junhyeong1211/visionpick-arm/media/figures/2026-11-11_fable-linkage-concept-not-physical.png

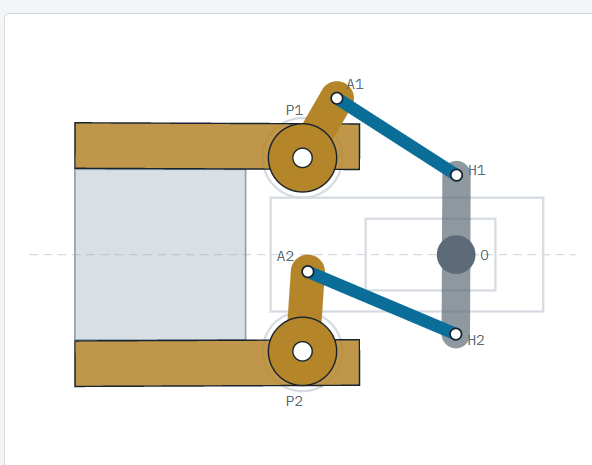
media/figures/2026-11-11_fable-linkage-concept-not-physical.png
