junhyeong1211/visionpick-arm/media/figures/2026-11-11_j5-gap-vs-servo-angle-2d.png

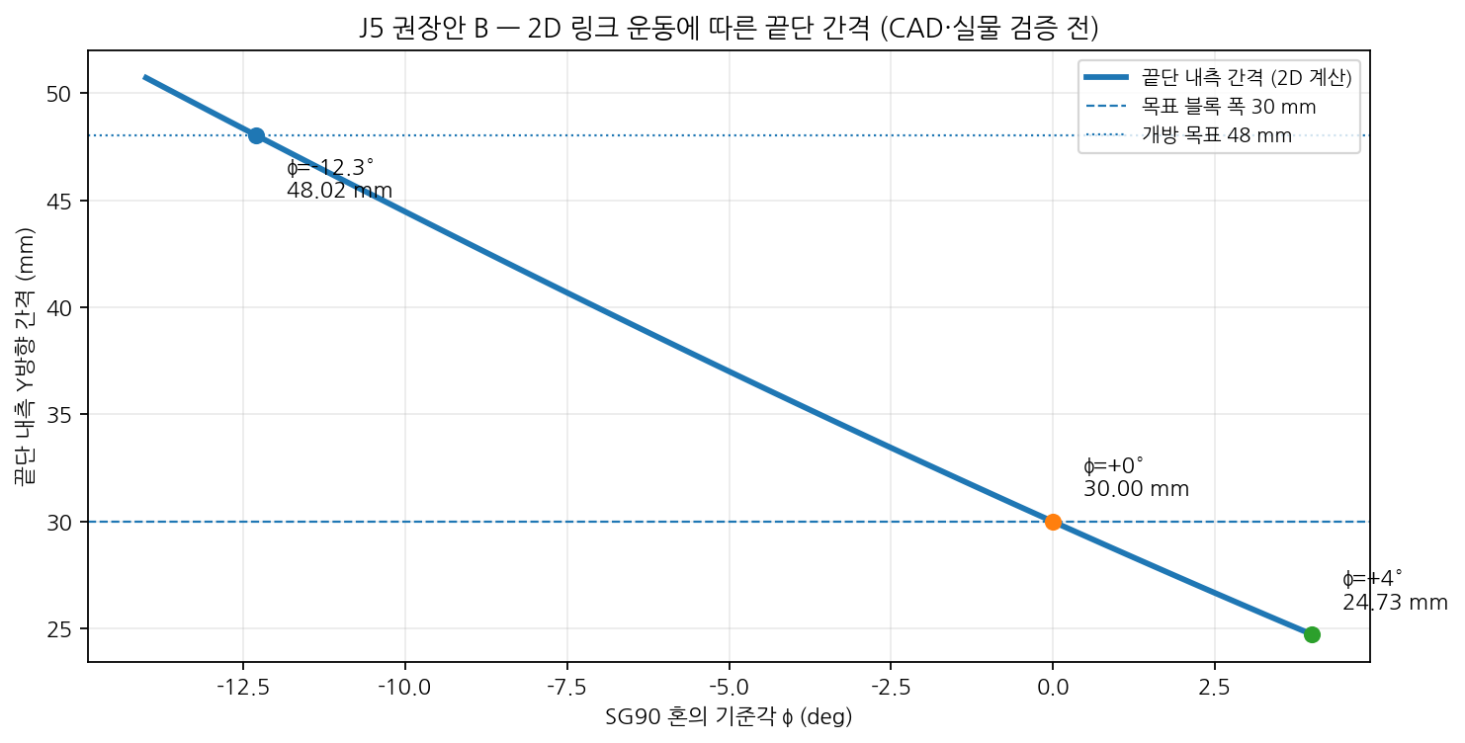
media/figures/2026-11-11_j5-gap-vs-servo-angle-2d.png
