junhyeong1211/visionpick-arm/media/figures/2026-11-11_j5-three-poses-2d.png

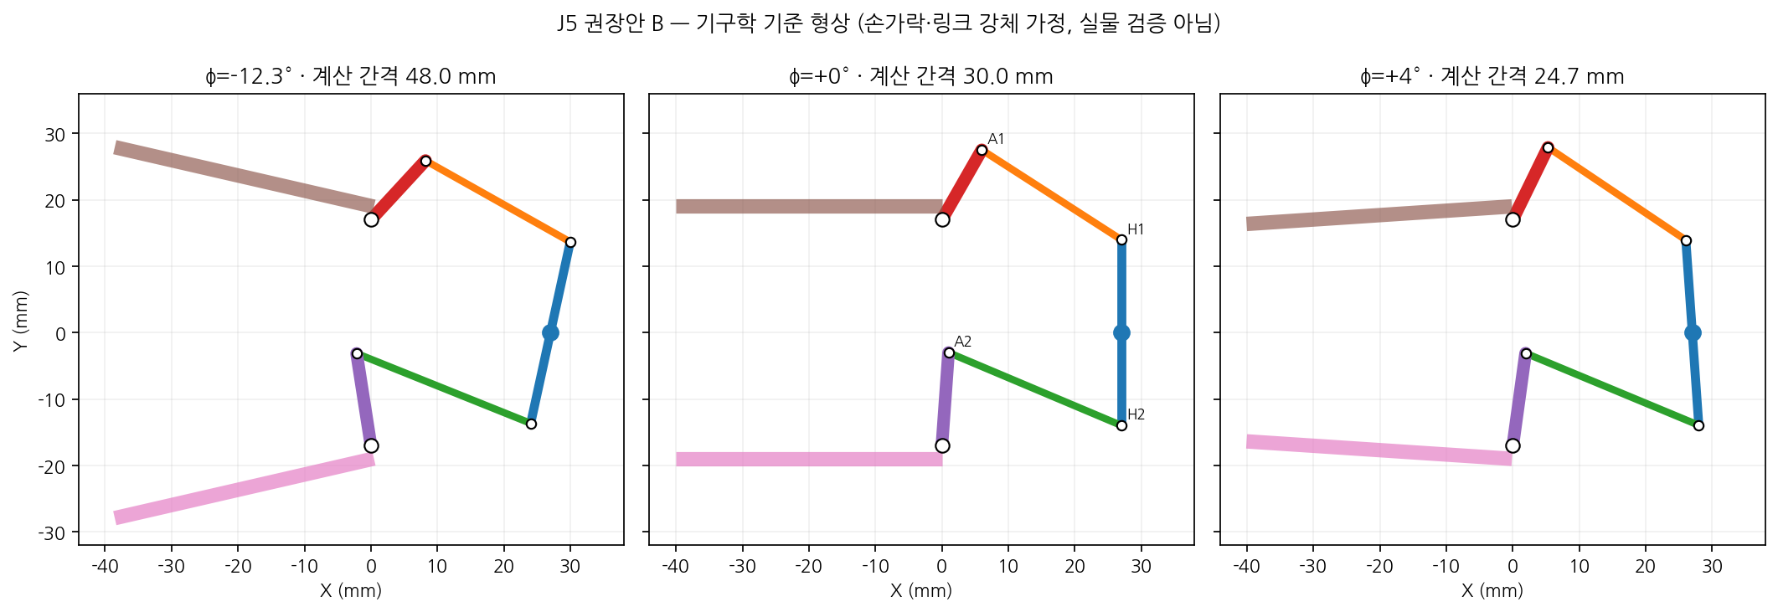
media/figures/2026-11-11_j5-three-poses-2d.png
