junhyeong1211/visionpick-arm/media/photos/2026-11-09_j1-j2-physical-fitup.jpg

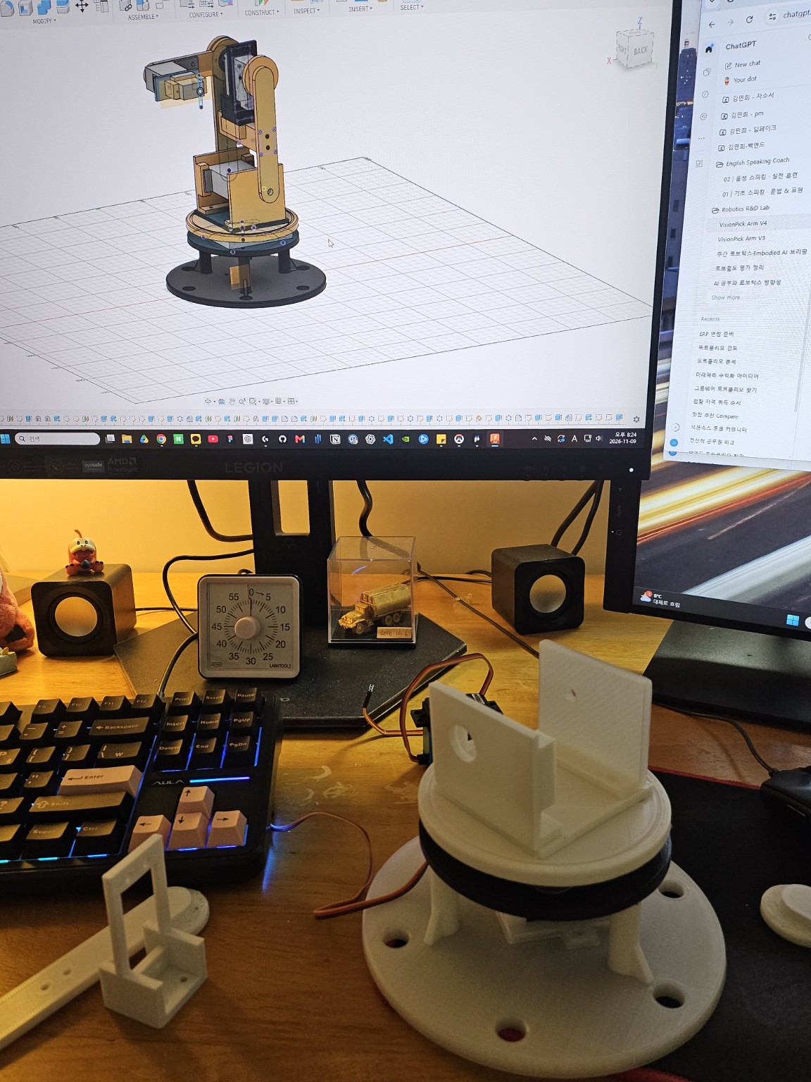
media/photos/2026-11-09_j1-j2-physical-fitup.jpg
