junhyeong1211/visionpick-arm/media/photos/2026-11-09_j5-finger-left-cad-wip.png

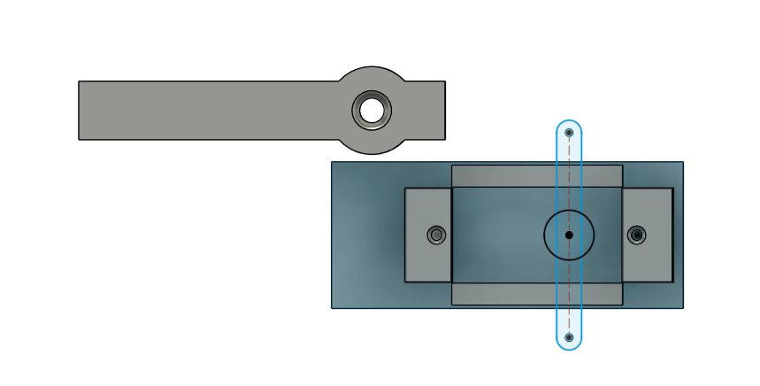
media/photos/2026-11-09_j5-finger-left-cad-wip.png
