junhyeong1211/visionpick-arm/media/photos/2026-11-09_j5-pivot-ribs-cad-wip.png

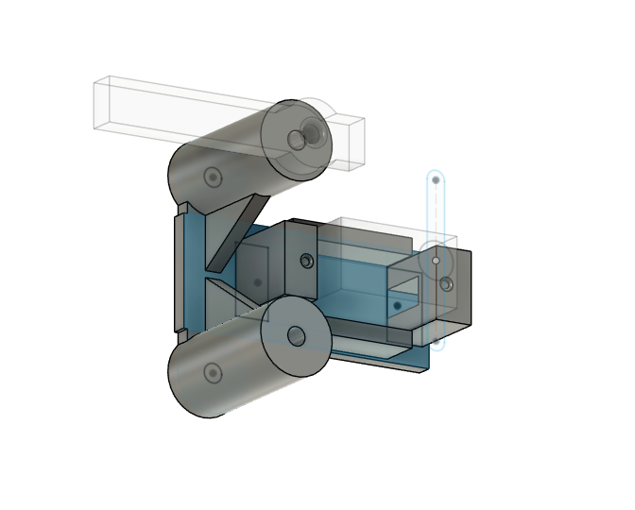
media/photos/2026-11-09_j5-pivot-ribs-cad-wip.png
