junhyeong1211/visionpick-arm/media/photos/2026-11-11_j5-30mm-parallel-gap-cad.png

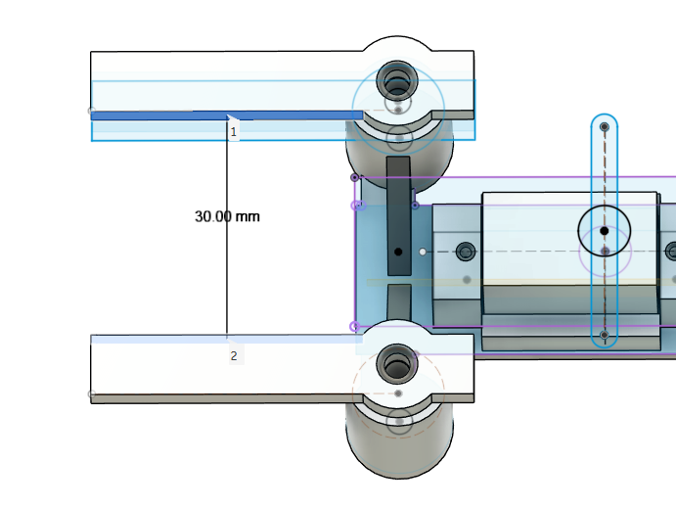
media/photos/2026-11-11_j5-30mm-parallel-gap-cad.png
