junhyeong1211/visionpick-arm/media/photos/2026-11-11_j5-stl-hfb-files.png

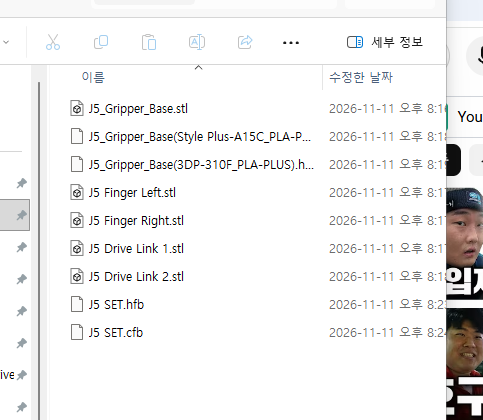
media/photos/2026-11-11_j5-stl-hfb-files.png
