junhyeong1211/visionpick-arm/media/photos/2026-11-14_j2-shoulder-plate-fitup-wip.jpg

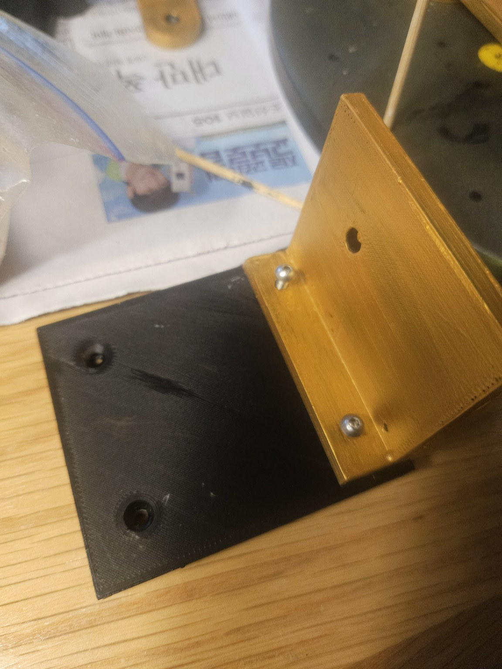
media/photos/2026-11-14_j2-shoulder-plate-fitup-wip.jpg
