junhyeong1211/visionpick-arm/media/photos/2026_11_01_j1-section-wip.png

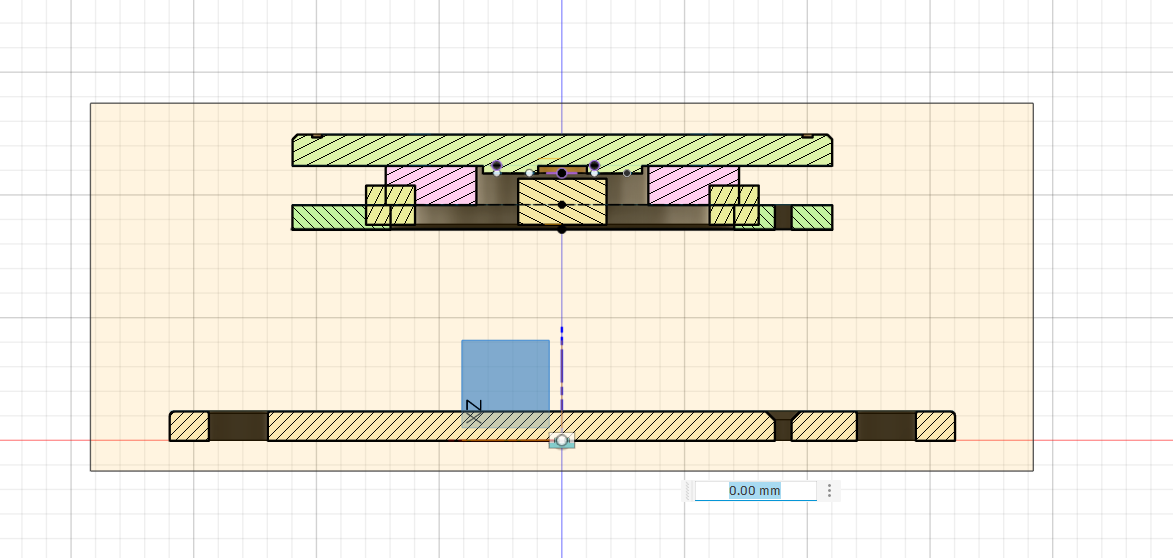
media/photos/2026_11_01_j1-section-wip.png
