junhyeong1211/visionpick-arm/(list of files, cad)

Other CAD files:
cad/fusion/VisionPick_Assembly_2026-11-01_J1_Horn6_WIP.f3d
cad/fusion/VisionPick_Assembly_2026-11-02_J1_Bearing_WIP.f3d
