junhyeong1211/visionpick-arm/media/photos/2026-10-22_concept-assembly.png

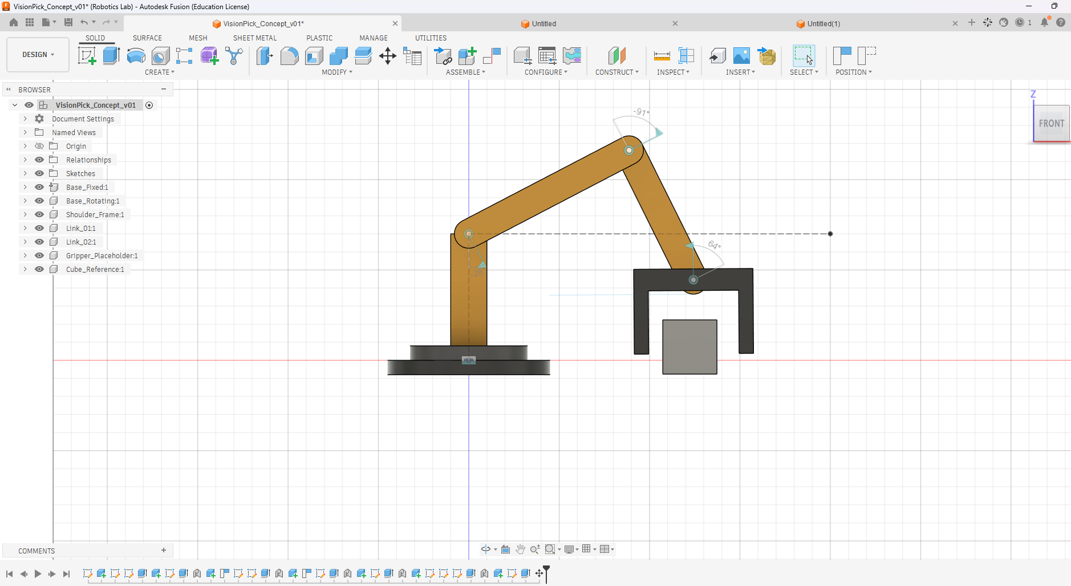
media/photos/2026-10-22_concept-assembly.png
