junhyeong1211/visionpick-arm/media/photos/2026-11-11_assembly-overview-cad-wip.png

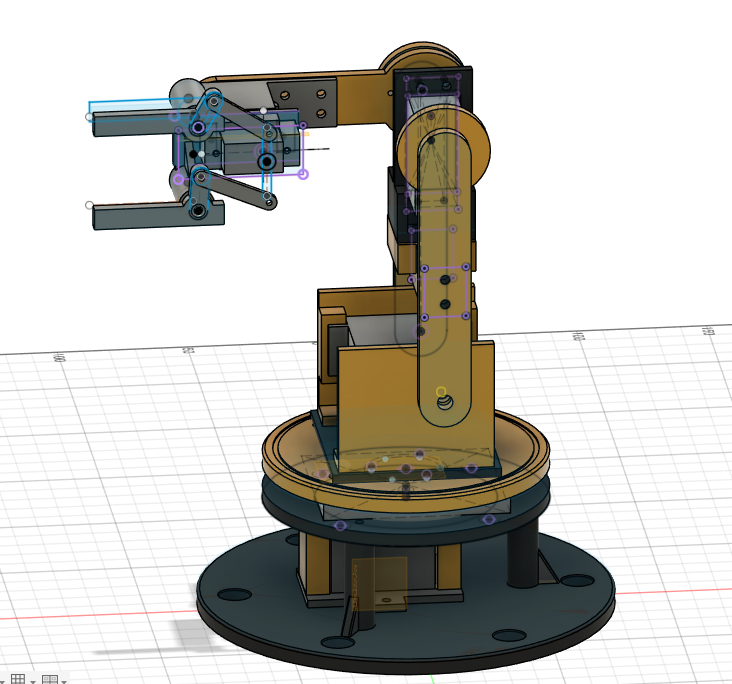
media/photos/2026-11-11_assembly-overview-cad-wip.png
