junhyeong1211/visionpick-arm/media/photos/2026-11-11_j5-assembled-linkage-cad-wip.png

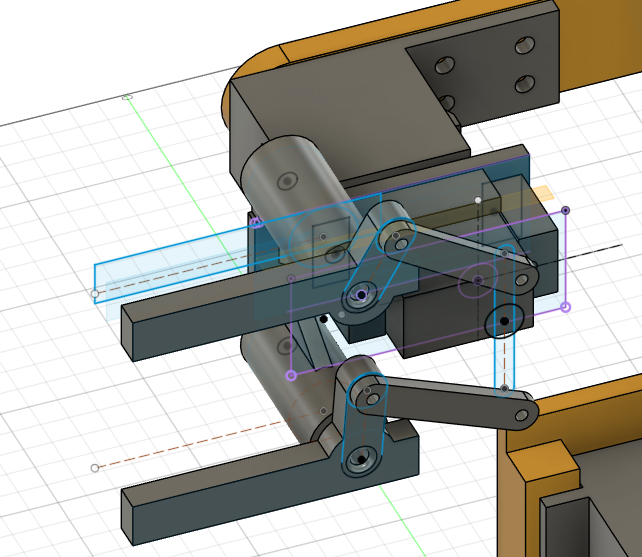
media/photos/2026-11-11_j5-assembled-linkage-cad-wip.png
