junhyeong1211/visionpick-arm/media/photos/2026-11-14_makerspace-workbench-reference.jpg

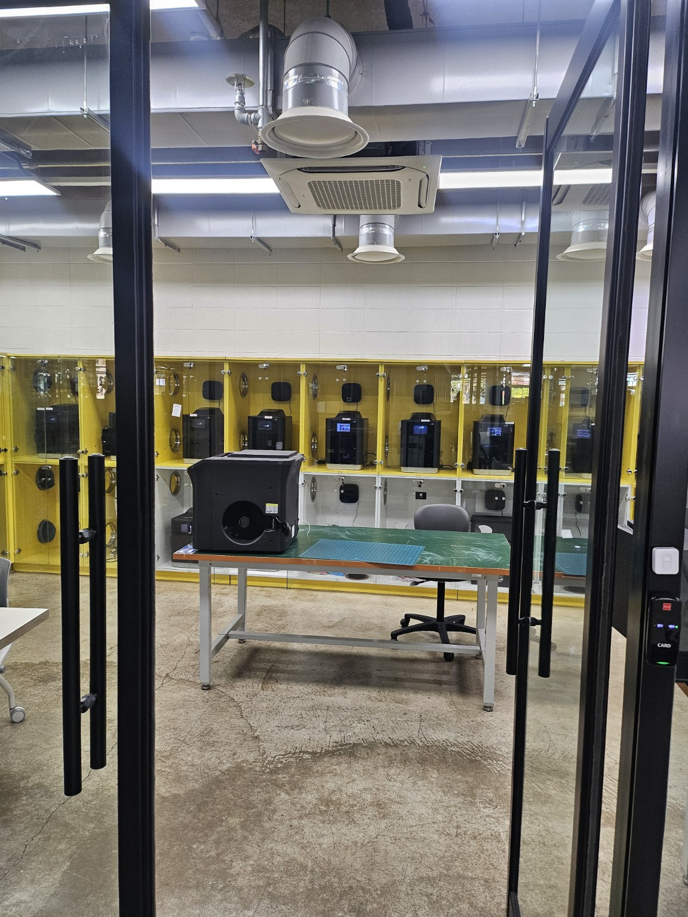
media/photos/2026-11-14_makerspace-workbench-reference.jpg
