junhyeong1211/visionpick-arm/media/photos/2026_11_01_assembly-overview-wip.png

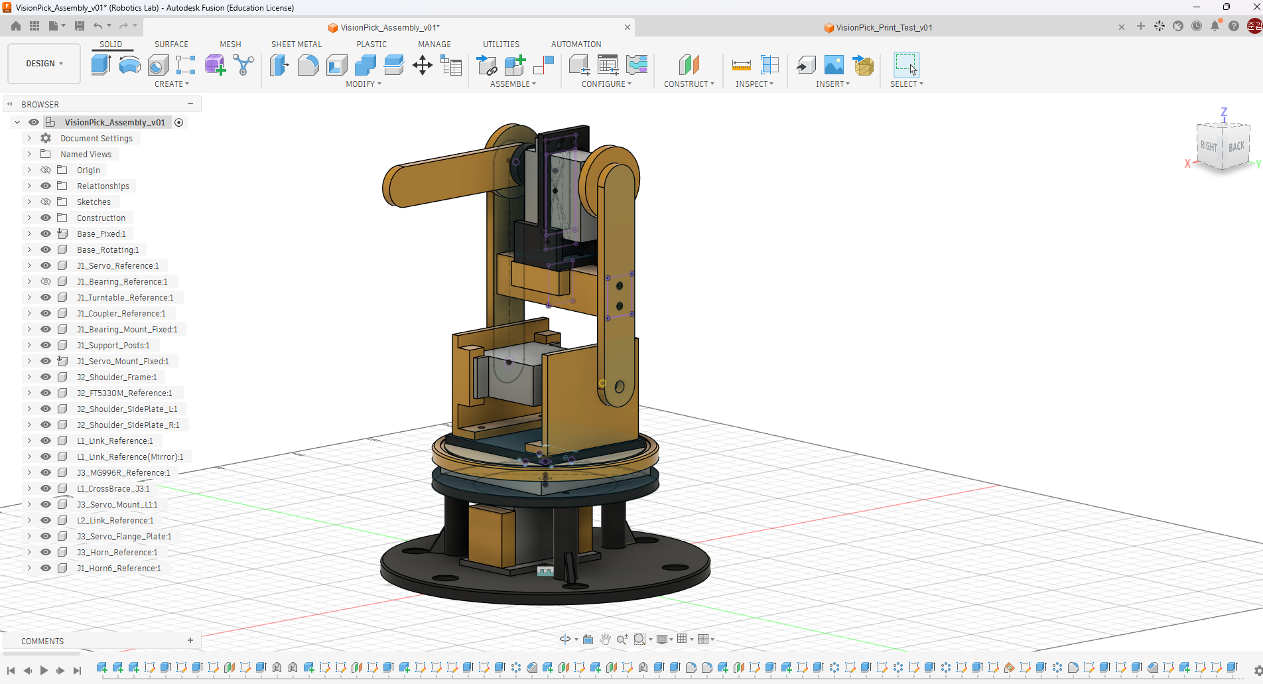
media/photos/2026_11_01_assembly-overview-wip.png
