junhyeong1211/visionpick-arm/media/photos/2026-10-22_gripper-reach-test.png

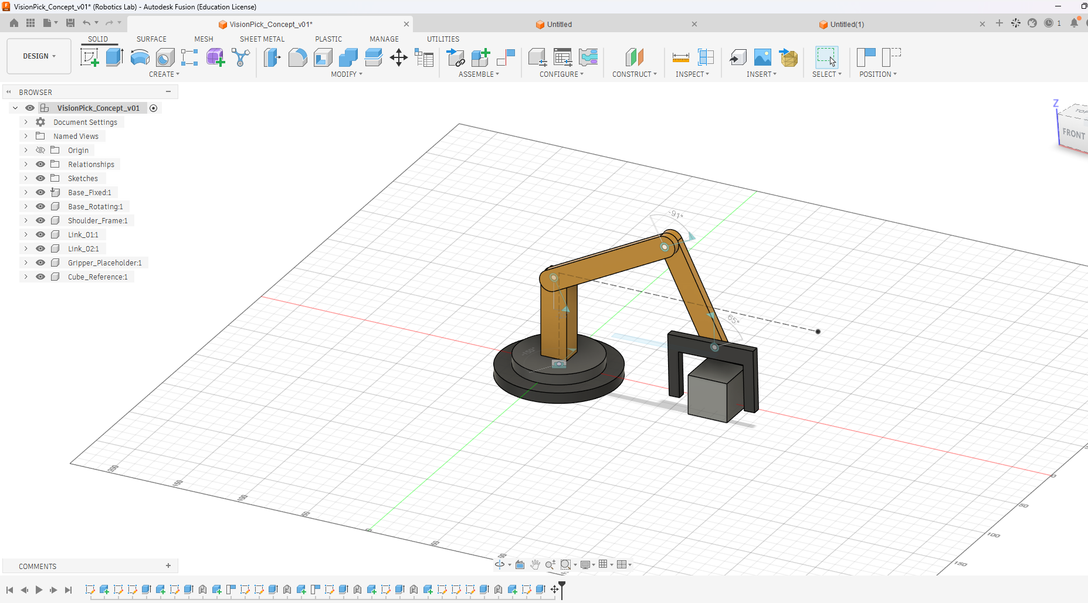
media/photos/2026-10-22_gripper-reach-test.png
