junhyeong1211/visionpick-arm/(commit log)

2026-10-22 Add HUSKYLENS color filter functionality
    Implement basic functionality for HUSKYLENS color detection.
2026-10-27 Revise experiments documentation for VisionPick Arm V1
    Updated the experiment documentation for VisionPick Arm V1, including experiment conditions, results, and limitations for multiple experiments.
2026-10-27 refresh project README with 4-DOF progress
    Updated project details and objectives for the VisionPick Arm, including changes to the description, project goals, system architecture, and development progress.
2026-11-01 Revise README with project updates and details
    Updated project details, objectives, and current status in README.
2026-11-01 Remove CAD snapshot upload plan from README
    Removed CAD snapshot upload plan section from README.
2026-11-01 Revise design decisions and updates for VisionPick Arm
    Updated design decisions and technical reviews for VisionPick Arm, including changes in robot configuration, vision system, kinematics validation, and component selection.
2026-11-01 Revise experiments documentation for VisionPick Arm
    Updated the experimental documentation for VisionPick Arm, including objectives, results, and limitations for each experiment.
2026-11-09 Revise design decisions and update verification statuses
    Updated design decisions and verification statuses, including modifications to J5 Base for cable exit and new assembly observations for J2 and J5 components.
2026-11-09 Update print statement from 'Hello' to 'Goodbye'
2026-11-11 Revise design decisions and update dates
    Updated the design decisions document with the latest changes and clarifications regarding the J5 Gripper and other components.
2026-11-14 Fix image reference in design decisions document
    Corrected image reference for J2 opposite pivot CAD.
